Avinashnetlink/Table-robot/images/bob-circuit-1.png

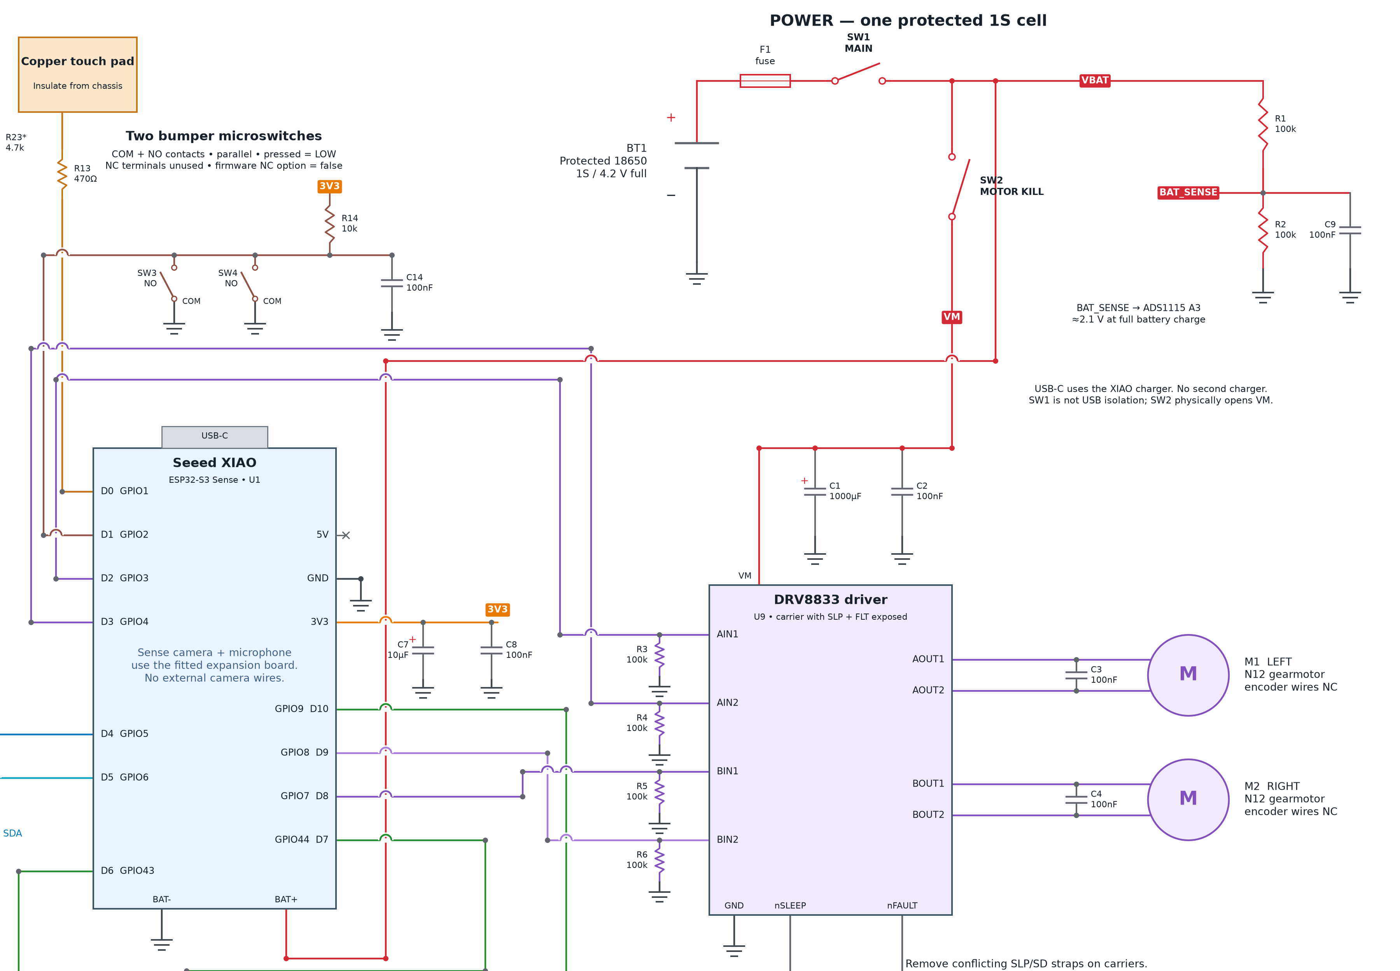
images/bob-circuit-1.png
