Avinashnetlink/Table-robot/images/bob-circuit-2.png

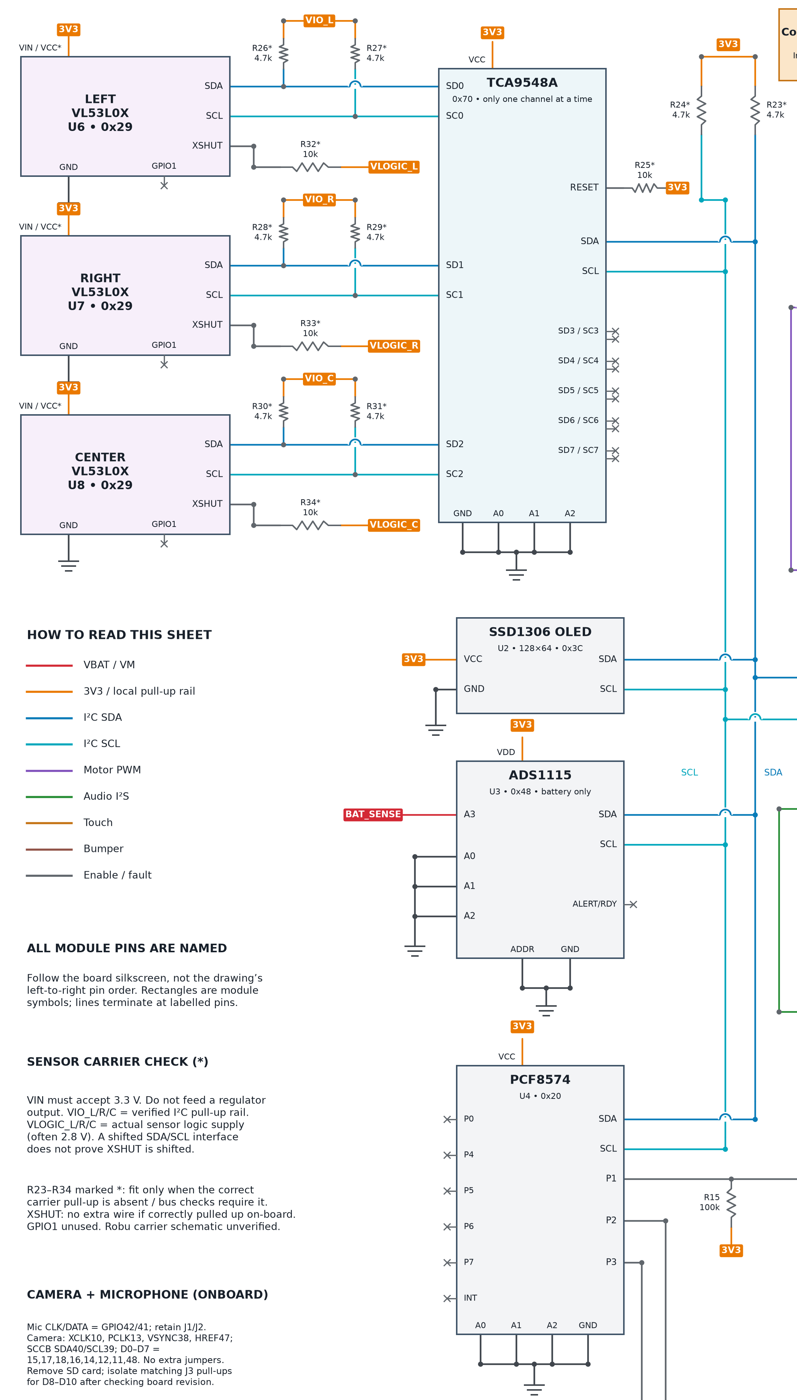
images/bob-circuit-2.png
