Avinashnetlink/Table-robot/images/bob-circuit-3.png

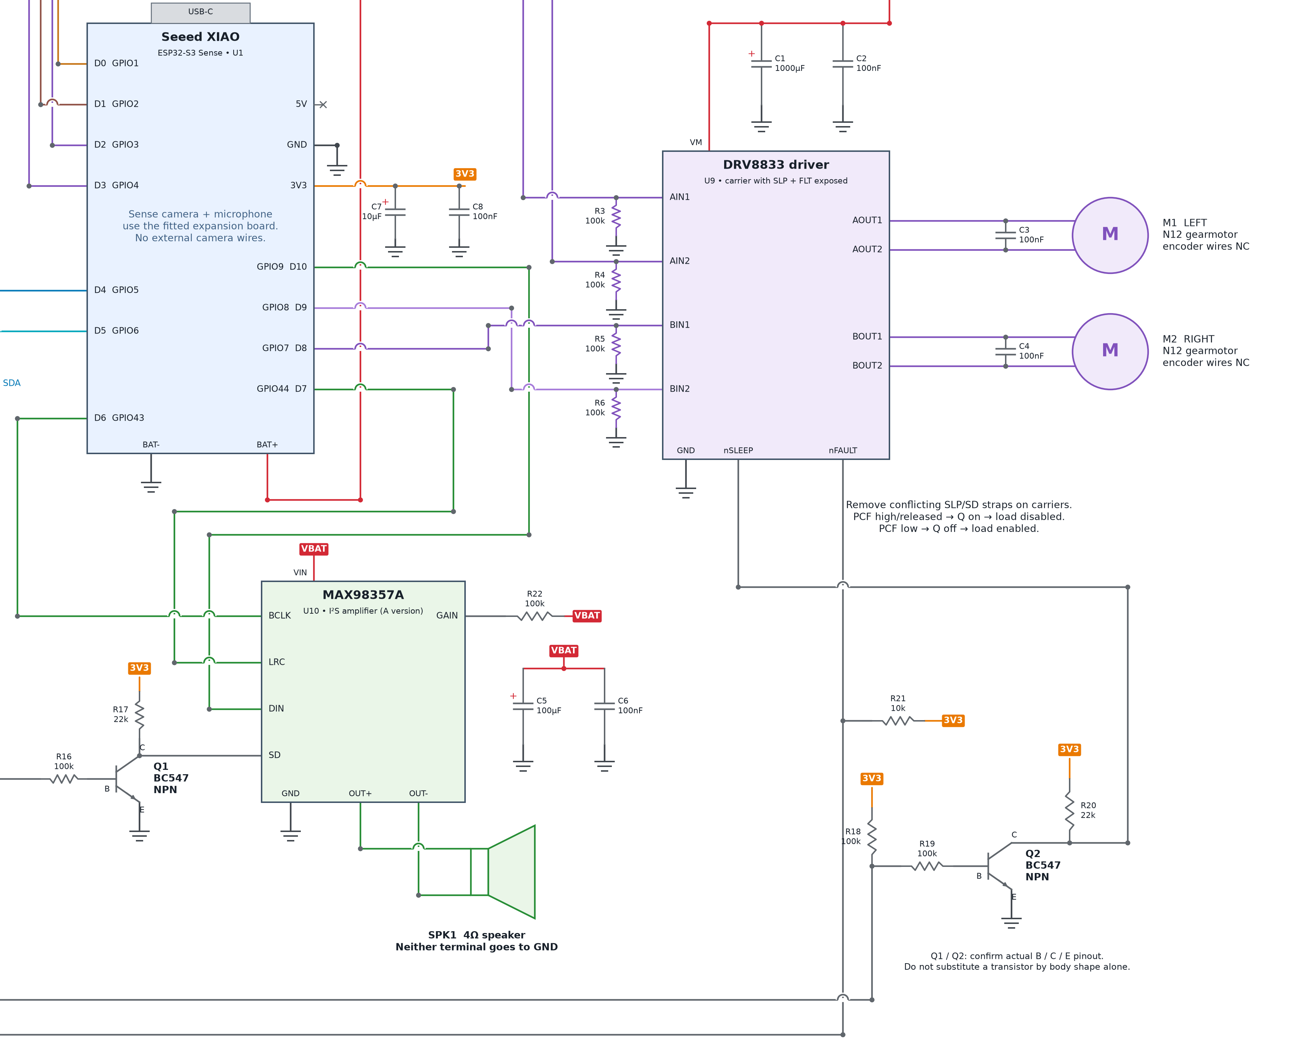
images/bob-circuit-3.png
