Avinashnetlink/Table-robot/code/bob/safety.h

#pragma once
#include <Arduino.h>
#include "motion.h"

struct SafetySnapshot {
  float battery;
  bool batteryValid, batteryOk, batteryWarn;
  bool sensorsOk;
  bool table[3];  // left, right, center
  uint16_t edgeMm[3];
  uint8_t edgeStatus[3];
  bool edgeValid[3];
  bool bumper, fault;
  bool moving;
  Dir dir;
  bool patrol, unlocked, speaking;
  bool linkOk, calibrated, sleepRequested;
  uint32_t sampleAt, batteryAt, cycleMs, maxCycleMs;
  const char *stopReason;
  uint32_t cycles;  // sensor cycles completed
};

struct SafetyEvent {
  const char *what;    // "move_result", "stopped", "bumper", "fault", "sensor", "battery", "patrol"
  const char *detail;  // reason, always a string literal
  bool ok;
};

// The safety task runs independently; acquisition timing is reported in telemetry,
// and is the only code that starts the motors.
bool safetyBegin(bool healthy);
bool safetySuspend();  // before deep sleep: motors off, task stops using I2C

SafetySnapshot safetyGet();
bool safetyPopEvent(SafetyEvent &e);

bool safetyRequestMove(Dir d, int dutyPercent, uint32_t ms);  // result arrives as a "move_result" event
void safetyStopAll(const char *why);  // serialized stop, queue purge and relock
void safetySetPatrol(bool on);
void safetySetUnlocked(bool on);
void safetySetSpeaking(bool on);  // no motion while the speaker plays

void safetyHeartbeat();
