Avinashnetlink/Table-robot/code/tests/T01_camera/secrets.example.h

#pragma once

// Copy this file to secrets.h. Leave both strings empty to skip Wi-Fi
// and only print photos on the Serial Monitor.
// secrets.h is listed in .gitignore so the Wi-Fi password is not pushed.
const char *WIFI_SSID = "";
const char *WIFI_PASSWORD = "";
