Avinashnetlink/Table-robot/(commit log)

2026-10-14 Add initial project files for Bob robot, including configuration, wiring diagrams, and component lists
    - Created .gitignore to exclude sensitive files and build artifacts.
    - Added Bob-pins.md for detailed pin diagram and wiring instructions.
    - Introduced Bob-products.md listing required components and their sources.
    - Developed Bob-simple.md outlining the robot's behavior and functionality.
    - Established BOB.md as the main project documentation.
    - Included README.md for code structure and setup instructions.
    - Implemented audio handling in audio.cpp and audio.h for microphone and speaker functionality.
    - Added camera handling in camera.cpp and camera.h for image capture.
    - Set up bus communi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
2026-10-15 Add upgrade plan for Bob robot, detailing gaps, improvements, and security measures
    - Introduced Bob-upgrade.md to outline the current state of the code and identify discrepancies with the original plan.
    - Documented existing functionality, including voice commands and motion control conditions.
    - Listed gaps between the written plan and the current implementation, highlighting areas for improvement.
    - Proposed enhancements for safety, command recognition, and data handling.
    - Addressed security concerns related to network access and device communication.
    This commit establishes a comprehensive upgrade plan to guide future development and ensure alignment with project goals.
2026-10-17 Update edge sensor default and enhance circuit documentation
    - Changed default edge sensor from "vl6180x" to "vl53l0x" in build_firmware.py.
    - Updated circuit generation script to reflect revision 3.1, including:
    - Revised titles and descriptions for clarity.
    - Enhanced wiring details for three downward VL53L0X modules.
    - Added detailed module-level schematics for better understanding.
    - Improved notes and instructions for wiring and component connections.
2026-10-17 Enhance documentation and testing resources
    - Updated CIRCUIT.md to include a reference to the hardware test index for individual diagnostics.
    - Revised TESTING.md to guide users to the hardware test index for component circuits and upload steps.
    - Expanded VALIDATION.md with details on component test circuits, added local diagrams for T01–T13 tests, and included validation results.
    - Created README.md for the tests directory, outlining automated software tests and their purposes.
    - Introduced README.md for the tools directory, detailing helper scripts and their functionalities.
    - Added draw_test_circuits.py script to generate local pin-level diagrams for each hardware test.
